AiFrame/Power_Rhythm_32/README.md

Power_Rhythm_32
===============

32 channels servo controller source code
