AiFrame/Power_Rhythm_32/Eagle_files/eagle_PowerRhythm32_V2.00/PowerRhythm32_brd.pdf

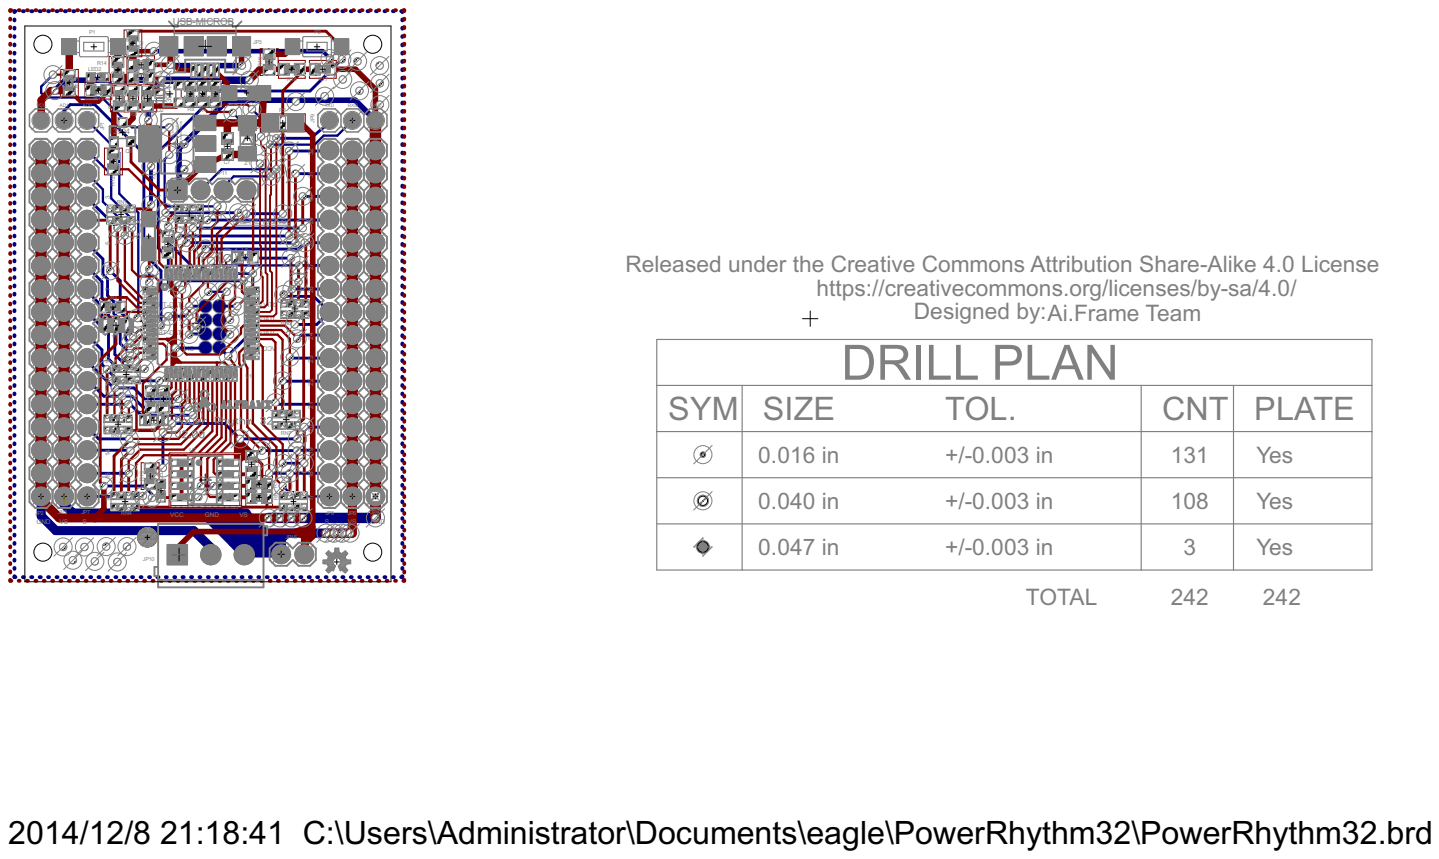
[picture p15: page 1]

GND TXD RXD VCC

https://creativecommons.org/licenses/by-sa/4.0/

Designed by:Ai.Frame Team

2014/12/8 21:18:41 C:\Users\Administrator\Documents\eagle\PowerRhythm32\PowerRhythm32.brd
