AiFrame/Power_Rhythm_32/Eagle_files/eagle_PowerRhythm32_V2.00/PowerRhythm32_sch.pdf

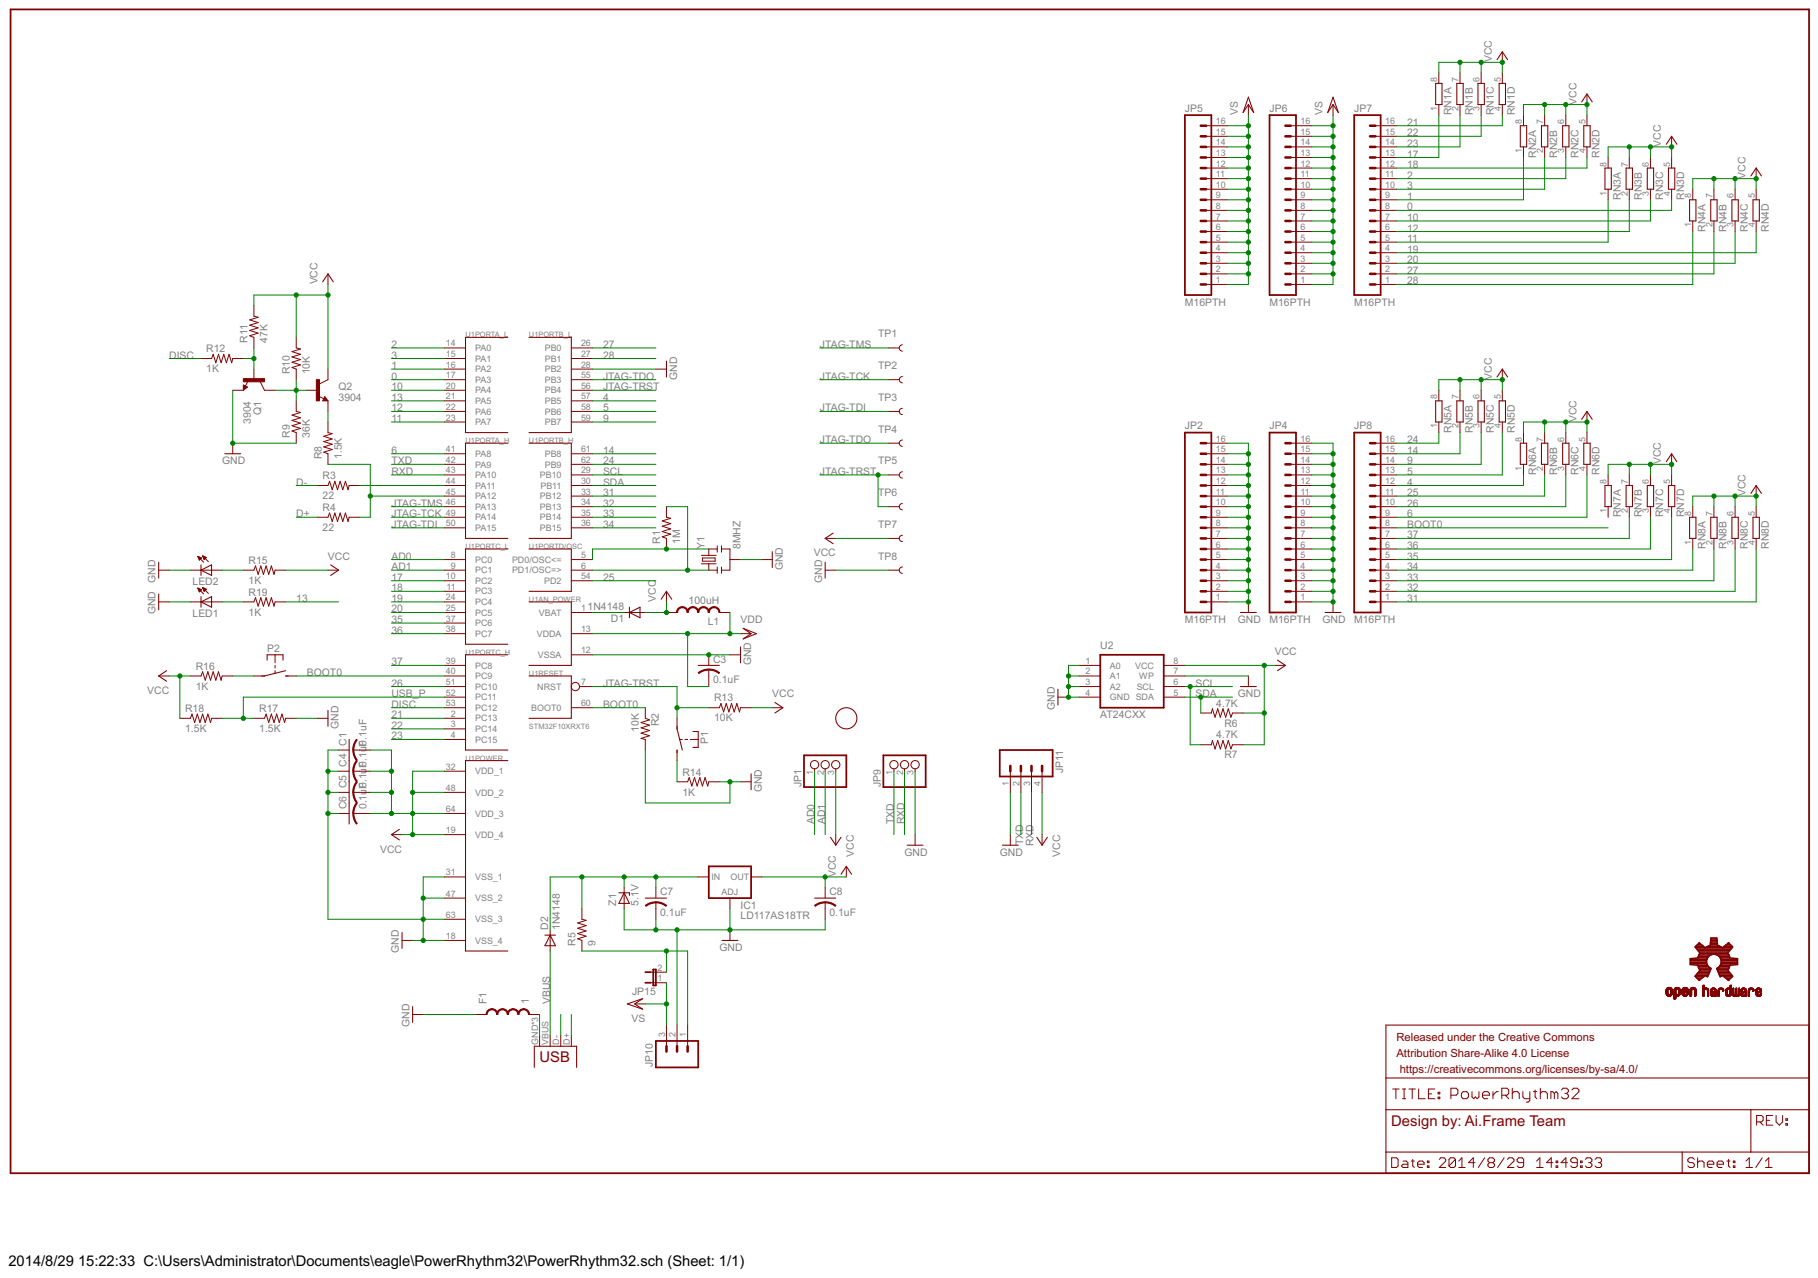
[picture p16: page 1]

Released under the Creative Commons Attribution Share-Alike 4.0 License

https://creativecommons.org/licenses/by-sa/4.0/

2014/8/29 15:22:33 C:\Users\Administrator\Documents\eagle\PowerRhythm32\PowerRhythm32.sch (Sheet: 1/1)
