AiFrame/Power_Rhythm_32/Eagle_files/eagle_PowerRhythm32_V2.01/PowerRhythm32.brd

## EAGLE design Eagle_files/eagle_PowerRhythm32_V2.01/PowerRhythm32.brd (2015-08-26)

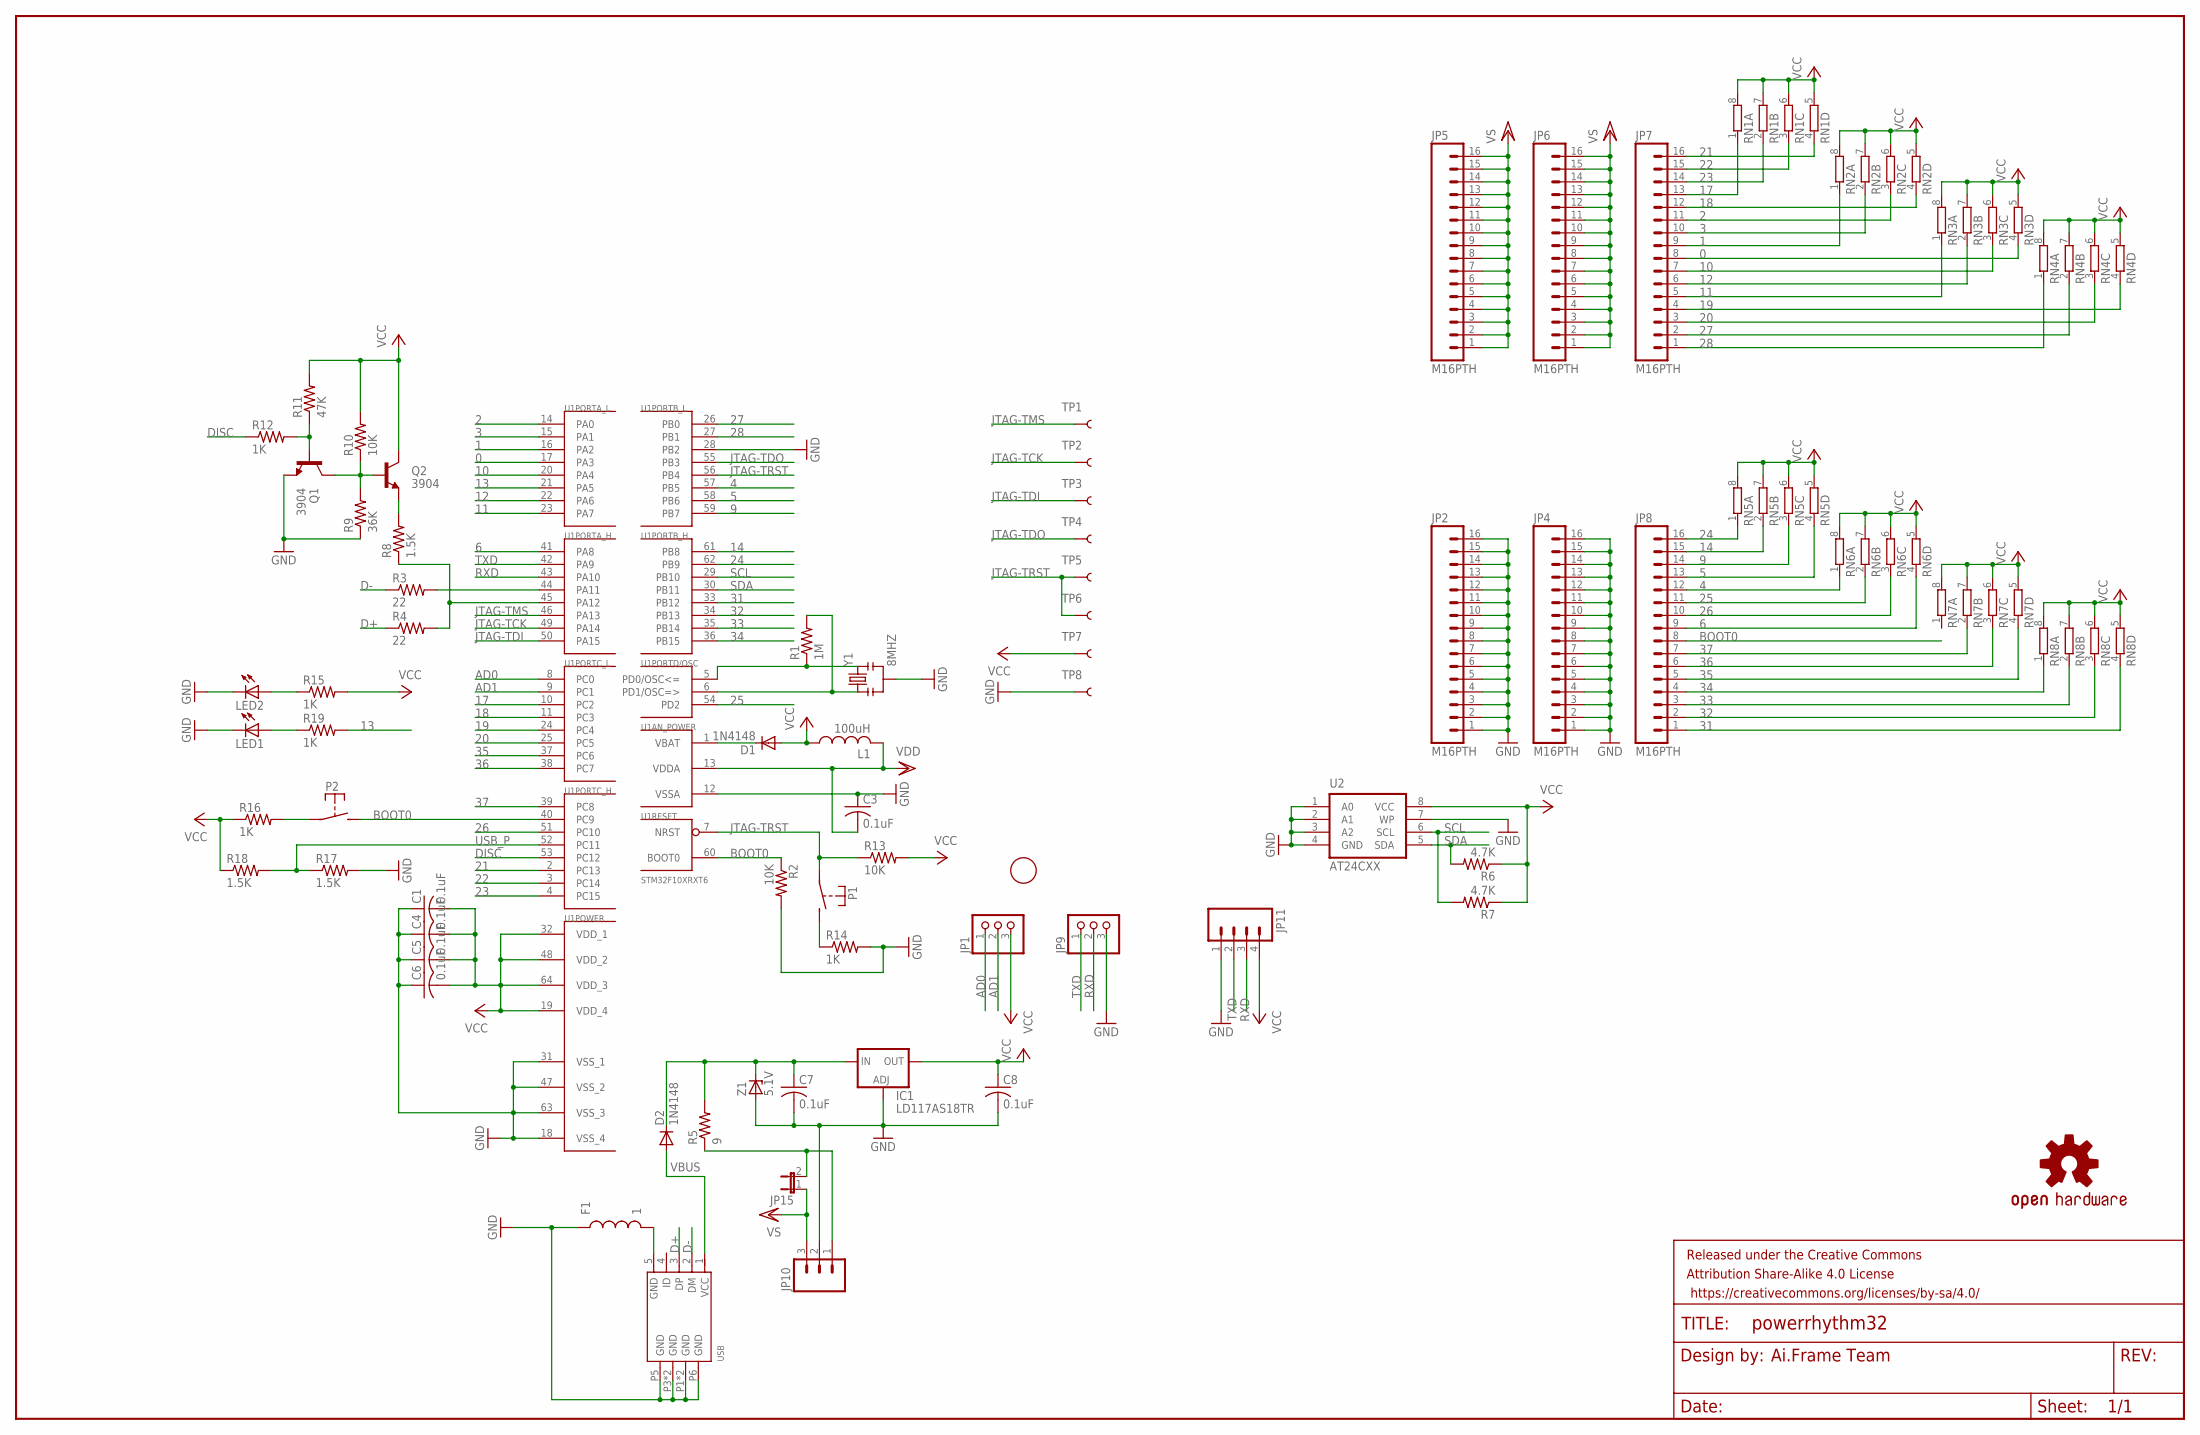
[picture p17: schematic PowerRhythm32.sch]

Parts:
C1, C3, C4, C5, C6, C7, C8: 0.1uF; C0603K
D1, D2: 1N4148; SOD123
F1: 1; 0805
FRAME1: FRAME-LEDGER; CREATIVE_COMMONS
IC1: LD117AS18TR; SOT223
JP1, JP9: PINHD-1X3; 1X03
JP2, JP4, JP5, JP6, JP7, JP8: M16PTH; 1X16
JP10: M03SCREW_LOCK; SCREWTERMINAL-3.5MM-3_LOCK.007S
JP11: M04PTH; 1X04
JP15: JUMPER-2PTH; 1X02
L1: 100uH; L2012C
LED1, LED2: LEDCHIP-LED0603; CHIP-LED0603
LOGO1: OSHW-LOGOS; OSHW-LOGO-S
P1, P2: TMAV433BAA
Q1, Q2: 3904; SOT23-3
R1: 1M; R0603
R2, R10, R13: 10K; R0603
R3, R4: 22; R0603
R5: 9; R1206
R6, R7: 4.7K; R0603
R8, R17, R18: 1.5K; R0603
R9: 36K; R0603
R11: 47K; R0603
R12, R14, R15, R16, R19: 1K; R0603
RN1, RN2, RN3, RN4, RN5, RN6, RN7, RN8: 4R-N0603-ARC; 0603-ARC
TP1, TP2, TP3, TP4, TP5, TP6, TP7, TP8: TEST-POINT3X5; PAD.03X.05
U1: STM32F10XRXT6; TQFP64
U2: AT24CXX; SO08-8S1
U$1: FIDUCIAL; FIDUCIAL_1MM
USB: MICRO-USB5+4P'5+6P'; MICRO-USB5+6P-SMD-0.65-AB
Y1: 8MHZ; RESONATOR-SMD
Z1: 5.1V; SOD80C

Connections:
0: JP7.8, RN3.4 (1), U1.17 (PA3)
1: JP7.9, RN2.1, U1.16 (PA2)
2: JP7.11, RN2.3 (1), U1.14 (PA0)
3: JP7.10, RN2.2 (1), U1.15 (PA1)
4: JP8.12, RN6.1, U1.57 (PB5)
5: JP8.13, RN5.4 (1), U1.58 (PB6)
6: JP8.9, RN6.4 (1), U1.41 (PA8)
9: JP8.14, RN5.3 (1), U1.59 (PB7)
10: JP7.7, RN3.3 (1), U1.20 (PA4)
11: JP7.5, RN3.1, U1.23 (PA7)
12: JP7.6, RN3.2 (1), U1.22 (PA6)
13: R19.2, U1.21 (PA5)
14: JP8.15, RN5.2 (1), U1.61 (PB8)
17: JP7.13, RN1.1, U1.10 (PC2)
18: JP7.12, RN2.4 (1), U1.11 (PC3)
19: JP7.4, RN4.4 (1), U1.24 (PC4)
20: JP7.3, RN4.3 (1), U1.25 (PC5)
21: JP7.16, RN1.4 (1), U1.2 (PC13)
22: JP7.15, RN1.3 (1), U1.3 (PC14)
23: JP7.14, RN1.2 (1), U1.4 (PC15)
24: JP8.16, RN5.1, U1.62 (PB9)
25: JP8.11, RN6.2 (1), U1.54 (PD2)
26: JP8.10, RN6.3 (1), U1.51 (PC10)
27: JP7.2, RN4.2 (1), U1.26 (PB0)
28: JP7.1, RN4.1, U1.27 (PB1)
31: JP8.1, RN8.4 (1), U1.33 (PB12)
32: JP8.2, RN8.3 (1), U1.34 (PB13)
33: JP8.3, RN8.2 (1), U1.35 (PB14)
34: JP8.4, RN8.1, U1.36 (PB15)
35: JP8.5, RN7.4 (1), U1.37 (PC6)
36: JP8.6, RN7.3 (1), U1.38 (PC7)
37: JP8.7, RN7.2 (1), U1.39 (PC8)
AD0: JP1.1, U1.8 (PC0)
AD1: JP1.2, U1.9 (PC1)
BOOT0: JP8.8, P2.P$2 (S), R2.1, U1.40 (PC9), U1.60 (BOOT0)
D+: R4.1, USB.3 (DP)
D-: R3.1, USB.2 (DM)
DISC: R12.1, U1.53 (PC12)
GND: C1.1, C3.1, C4.1, C5.1, C6.1, C7.2, C8.2, F1.1, IC1.1 (ADJ), JP2.1, JP2.2, JP2.3, JP2.4, JP2.5, JP2.6, JP2.7, JP2.8, JP2.9, JP2.10, JP2.11, JP2.12, JP2.13, JP2.14, JP2.15, JP2.16, JP4.1, JP4.2, JP4.3, JP4.4, JP4.5, JP4.6, JP4.7, JP4.8, JP4.9, JP4.10, JP4.11, JP4.12, JP4.13, JP4.14, JP4.15, JP4.16, JP9.3, JP10.2, JP11.1, LED1.C, LED2.C, Q1.2 (E), R2.2, R9.1, R14.2, R17.2, TP8.P$1, U1.12 (VSSA), U1.18 (VSS_4), U1.28 (PB2), U1.31 (VSS_1), U1.47 (VSS_2), U1.63 (VSS_3), U2.1 (A0), U2.2 (A1), U2.3 (A2), U2.4 (GND), U2.7 (WP), USB.P1 (GND), USB.P2 (GND), USB.P3 (GND), USB.P4 (GND), USB.P5 (GND), USB.P6 (GND), Y1.2, Z1.A
JTAG-TCK: TP2.P$1, U1.49 (PA14)
JTAG-TDI: TP3.P$1, U1.50 (PA15)
JTAG-TDO: TP4.P$1, U1.55 (PB3)
JTAG-TMS: TP1.P$1, U1.46 (PA13)
JTAG-TRST: P1.P$1, R13.1, TP5.P$1, TP6.P$1, U1.7 (NRST), U1.56 (PB4)
unnamed: R1.2, U1.6 (PD1/OSC=>), Y1.1
unnamed: D1.C, U1.1 (VBAT)
unnamed: LED2.A, R15.1
unnamed: R4.2, R8.1, U1.45 (PA12)
unnamed: JP10.1, JP15.2, R5.1
unnamed: R1.1, U1.5 (PD0/OSC<=), Y1.3
unnamed: R3.2, U1.44 (PA11)
unnamed: C7.1, D2.C, IC1.3 (IN), R5.2, Z1.C
unnamed: LED1.A, R19.1
unnamed: F1.2, USB.5 (GND)
unnamed: Q1.3 (C), Q2.1 (B), R9.2, R10.1
unnamed: P1.P$2 (S), R14.1
unnamed: Q2.2 (E), R8.2
unnamed: Q1.1 (B), R11.1, R12.2
unnamed: P2.P$1, R16.2
RXD: JP9.2, JP11.3, U1.43 (PA10)
SCL: R7.2, U1.29 (PB10), U2.6 (SCL)
SDA: R6.2, U1.30 (PB11), U2.5 (SDA)
TXD: JP9.1, JP11.2, U1.42 (PA9)
USB_P: R17.1, R18.2, U1.52 (PC11)
VBUS: D2.A, USB.1 (VCC)
VCC: C1.2, C4.2, C5.2, C6.2, C8.1, D1.A, IC1.4 (OUT), JP1.3, JP11.4, L1.1, Q2.3 (C), R6.1, R7.1, R10.2, R11.2, R13.2, R15.2, R16.1, R18.1, RN1.5 (2), RN1.6 (2), RN1.7 (2), RN1.8 (2), RN2.5 (2), RN2.6 (2), RN2.7 (2), RN2.8 (2), RN3.5 (2), RN3.6 (2), RN3.7 (2), RN3.8 (2), RN4.5 (2), RN4.6 (2), RN4.7 (2), RN4.8 (2), RN5.5 (2), RN5.6 (2), RN5.7 (2), RN5.8 (2), RN6.5 (2), RN6.6 (2), RN6.7 (2), RN6.8 (2), RN7.5 (2), RN7.6 (2), RN7.7 (2), RN7.8 (2), RN8.5 (2), RN8.6 (2), RN8.7 (2), RN8.8 (2), TP7.P$1, U1.19 (VDD_4), U1.32 (VDD_1), U1.48 (VDD_2), U1.64 (VDD_3), U2.8 (VCC)
VCC/2: JP5.1, JP5.2, JP5.3, JP5.4, JP5.5, JP5.6, JP5.7, JP5.8, JP5.9, JP5.10, JP5.11, JP5.12, JP5.13, JP5.14, JP5.15, JP5.16, JP6.1, JP6.2, JP6.3, JP6.4, JP6.5, JP6.6, JP6.7, JP6.8, JP6.9, JP6.10, JP6.11, JP6.12, JP6.13, JP6.14, JP6.15, JP6.16, JP10.3, JP15.1
VDD: C3.2, L1.2, U1.13 (VDDA)

Notes on the sheet:
Ai.Frame Team

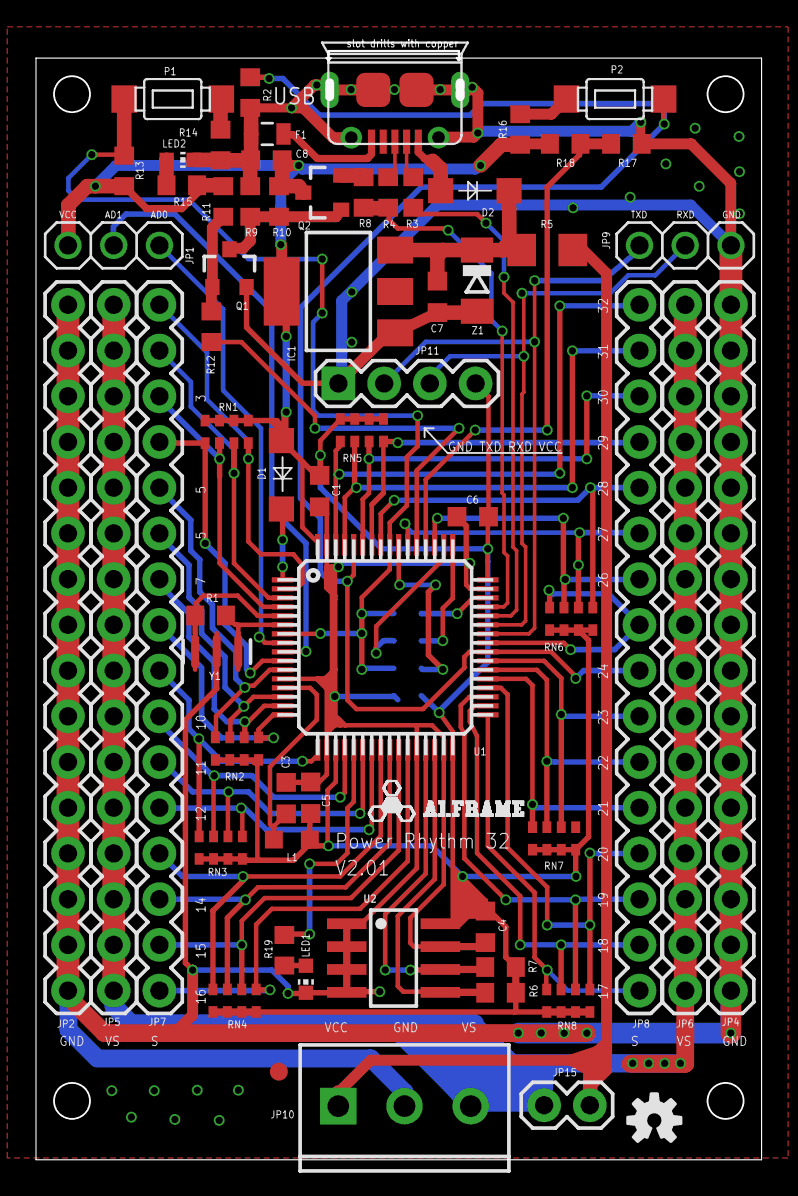
[picture p18: board PowerRhythm32.brd from above]

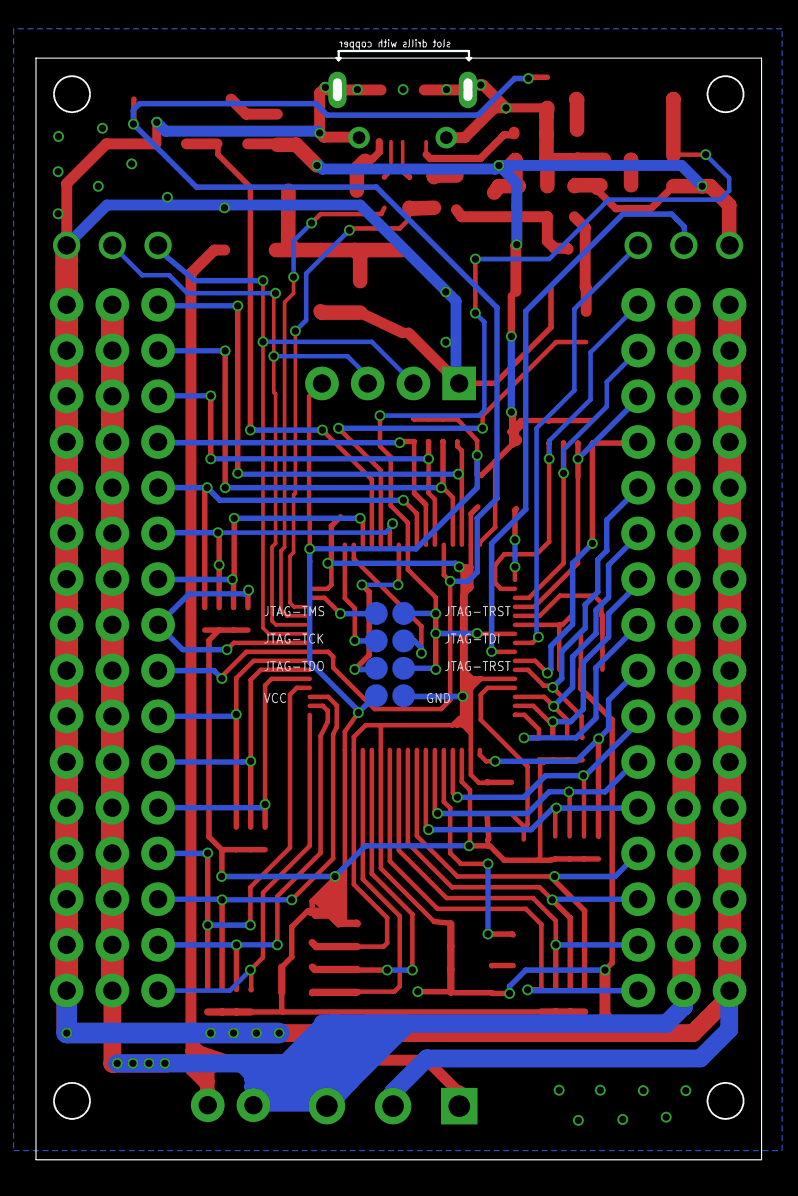
[picture p19: board PowerRhythm32.brd from below]

Board: 2 copper layers, 40.3 x 61.2 mm, 72 parts (8 on the bottom side), 68 nets.
