AiFrame/Power_Rhythm_32/(commit log)

2014-12-05 upload power_rhythm_32_Maple
    source code for the Maple REV 3
2014-12-05 eagle files upload
    [BOM.xls, PowerRhythm32.brd, PowerRhythm32.sch]
2014-12-08 UPDATE TO V1.0
    [BOM.xls, PowerRhythm32.brd, PowerRhythm32.sch]
2014-12-08 Update to 2.00
    [PowerRhythm32.brd, PowerRhythm32.sch]
2015-08-26 PCB update
    Update the USB design.
    [PowerRhythm32.brd, PowerRhythm32.sch]
2015-10-11 power_rhythm_32_Maple V1.3
    Add a time out mode for PWM output, when there is not command from uart
    or USB, the controller will shut down the PWM output in 5 seconds.
2015-10-11 power_rhythm_32_Maple_Firmware_V1.2
    Add a time out mode for PWM output, when there is not command from USB
    or UART, the controller with shut down the PWM output for saving battery
    in 5 seconeds
2015-10-11 power_rhythm_32_Maple_Firmware_V1.2
    ADD WATCH DOG
2015-11-02 1.2
    BATTERY CHECK MOD
