AiFrame/Power_Rhythm_32/(notices)

Notices in the files:
parts and their libraries:
memory-atmel: Copyright (C) 2008, Bob Starr
SparkFun-Connectors: Licensing: Creative Commons ShareAlike 4.0 International - https://creativecommons.org/licenses/by-sa/4.0
